uwezi/Eduino/README.md

# Eduino
Another ATmega32U4 breakout board
