uwezi/Eduino/documentation/20230210_eduino_pinout.pdf

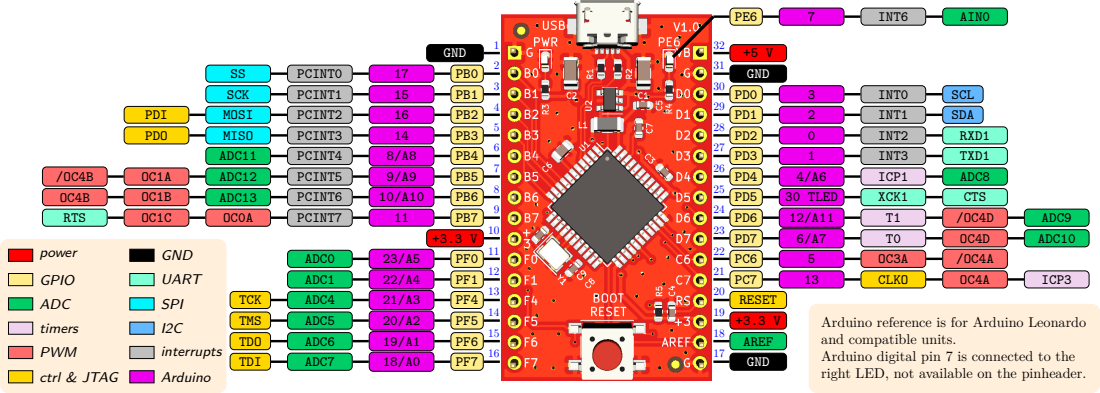
[picture p7: page 1]
32 GND; GND; AREF; RESET; PCINT0; SCK; PCINT1; PDI; MOSI; PCINT2; PDO; MISO; PCINT3; ADC11; PCINT4; ADC12; PCINT5; ADC13; PCINT6; RTS; PCINT7; ADC0; ADC1; TCK; ADC4; TMS; ADC5; TDO; ADC6; TDI; ADC7; CLKO; ICP3; INT0; SCL; INT1; SDA; INT2; RXD1; INT3; TXD1; ICP1; ADC8; 30 TLED; XCK1; CTS; ADC9; ADC10; INT6; AIN0; power; ctrl & JTAG; Arduino; GPIO; ADC; UART; SPI; timers; PWM; interrupts

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
