uwezi/Eduino/kicad/20210211_eduino.kicad_pcb

## KiCad design kicad/20210211_eduino.kicad_pcb (2021-02-11)

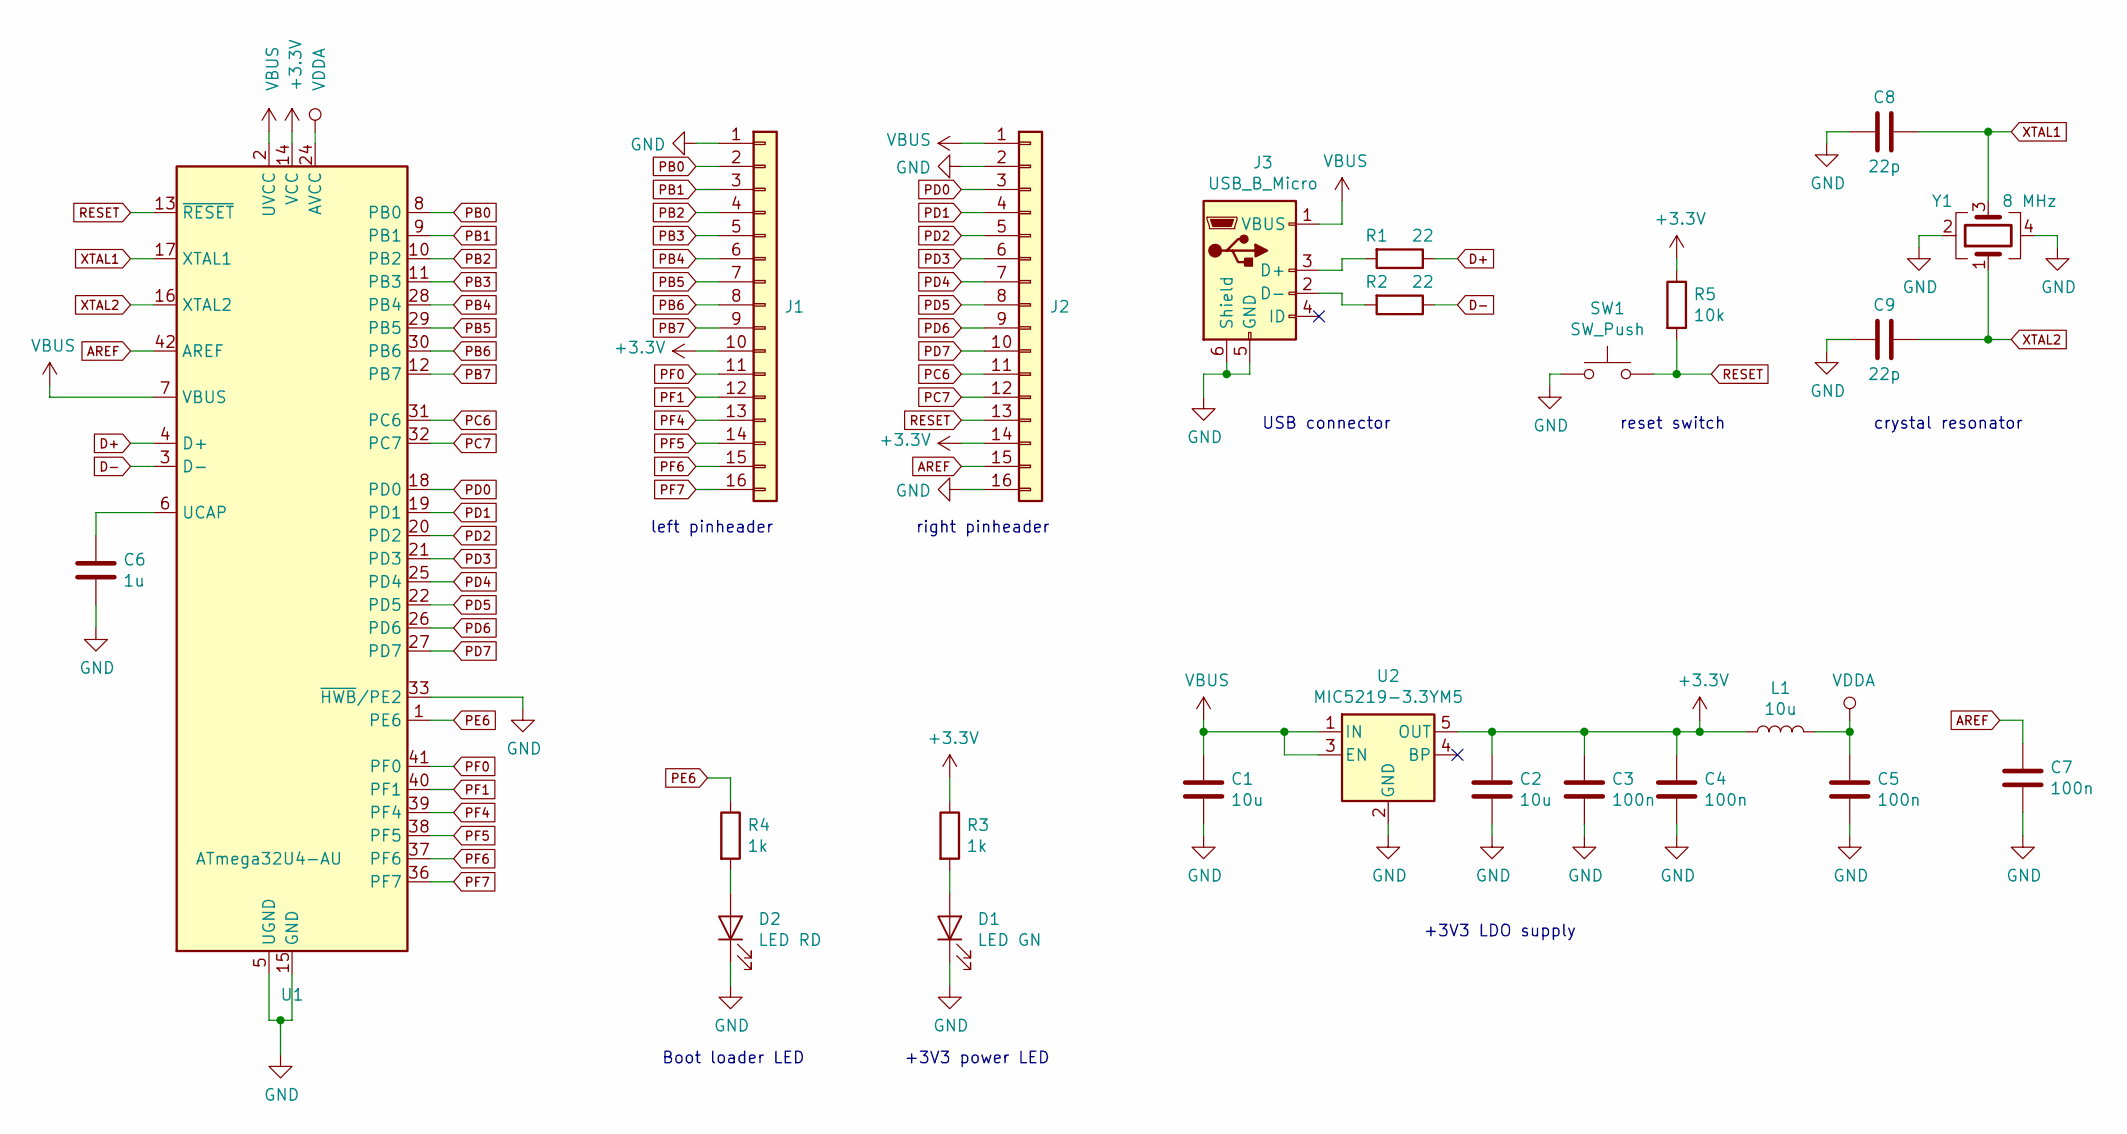
[picture p8: schematic 20210211_eduino.sch, ATmega32U4 Eduino]

Parts:
C1, C2: 10u; C_1206_3216Metric
C3, C4, C5, C7: 100n; C_0603_1608Metric
C6: 1u; C_0805_2012Metric
C8, C9: 22p; C_0603_1608Metric
D1: LED GN; LED_0603_1608Metric
D2: LED RD; LED_0603_1608Metric
J1, J2: Conn_01x16; PinHeader_1x16_P2.54mm_Vertical
J3: USB_B_Micro; micro-5P-Flat-welding-High-temperature_C40942
L1: 10u; L_1206_3216Metric
R1, R2: 22; R_0603_1608Metric
R3, R4: 1k; R_0603_1608Metric
R5: 10k; R_0603_1608Metric
SW1: SW_Push; SW_Push_1P1T_NO_6x6mm_H9.5mm
U1: ATmega32U4-AU; TQFP-44_10x10mm_P0.8mm
U2: MIC5219-3.3YM5; SOT-23-5
Y1: 8 MHz; Crystal_SMD_3225-4Pin_3.2x2.5mm

Connections:
+3V3: C2.1, C3.1, C4.1, J1.10, J2.14, L1.1, R3.1, R5.1, U1.14 (VCC), U1.34 (VCC), U2.5 (OUT)
AREF: C7.1, J2.15, U1.42 (AREF)
D+: R1.1, U1.4 (D+)
D-: R2.1, U1.3 (D-)
GND: C1.2, C2.2, C3.2, C4.2, C5.2, C6.2, C7.2, C8.1, C9.1, D1.1 (K), D2.1 (K), J1.1, J2.2, J2.16, J3.5 (GND), J3.6 (Shield), SW1.1, U1.5 (UGND), U1.15 (GND), U1.23 (GND), U1.33 (~HWB~/PE2), U1.35 (GND), U1.43 (GND), U2.2 (GND), Y1.2, Y1.4
unnamed: C6.1, U1.6 (UCAP)
unnamed: C8.2, U1.17 (XTAL1), Y1.3
unnamed: C9.2, U1.16 (XTAL2), Y1.1
unnamed: D1.2 (A), R3.2
unnamed: D2.2 (A), R4.2
unnamed: J3.2 (D-), R2.2
unnamed: J3.3 (D+), R1.2
PB0: J1.2, U1.8 (PB0)
PB1: J1.3, U1.9 (PB1)
PB2: J1.4, U1.10 (PB2)
PB3: J1.5, U1.11 (PB3)
PB4: J1.6, U1.28 (PB4)
PB5: J1.7, U1.29 (PB5)
PB6: J1.8, U1.30 (PB6)
PB7: J1.9, U1.12 (PB7)
PC6: J2.11, U1.31 (PC6)
PC7: J2.12, U1.32 (PC7)
PD0: J2.3, U1.18 (PD0)
PD1: J2.4, U1.19 (PD1)
PD2: J2.5, U1.20 (PD2)
PD3: J2.6, U1.21 (PD3)
PD4: J2.7, U1.25 (PD4)
PD5: J2.8, U1.22 (PD5)
PD6: J2.9, U1.26 (PD6)
PD7: J2.10, U1.27 (PD7)
PE6: R4.1, U1.1 (PE6)
PF0: J1.11, U1.41 (PF0)
PF1: J1.12, U1.40 (PF1)
PF4: J1.13, U1.39 (PF4)
PF5: J1.14, U1.38 (PF5)
PF6: J1.15, U1.37 (PF6)
PF7: J1.16, U1.36 (PF7)
RESET: J2.13, R5.2, SW1.2, U1.13 (~RESET)
VBUS: C1.1, J2.1, J3.1 (VBUS), U1.2 (UVCC), U1.7 (VBUS), U2.1 (IN), U2.3 (EN)
VDDA: C5.1, L1.2, U1.24 (AVCC), U1.44 (AVCC)

Notes on the sheet:
+3V3 power LED
Boot loader LED
left pinheader
right pinheader
+3V3 LDO supply
USB connector
reset switch
crystal resonator

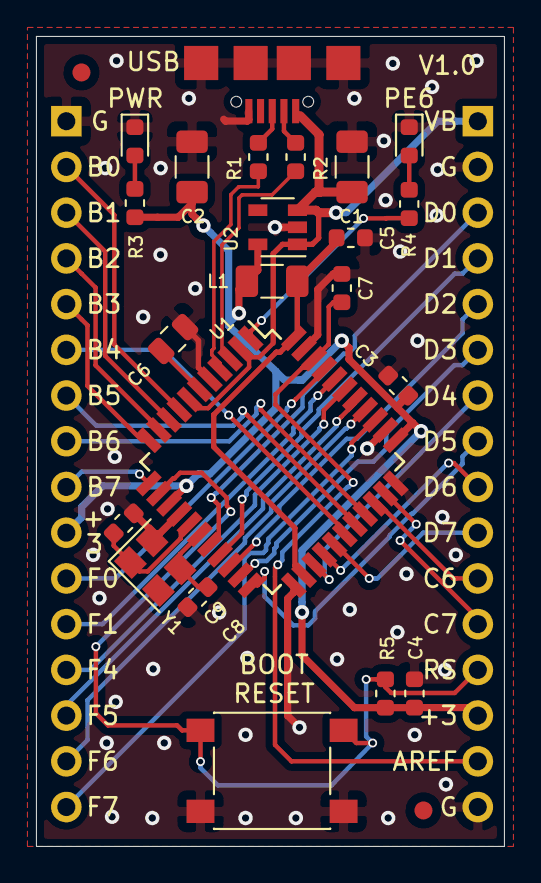
[picture p9: board 20210211_eduino.kicad_pcb from above]

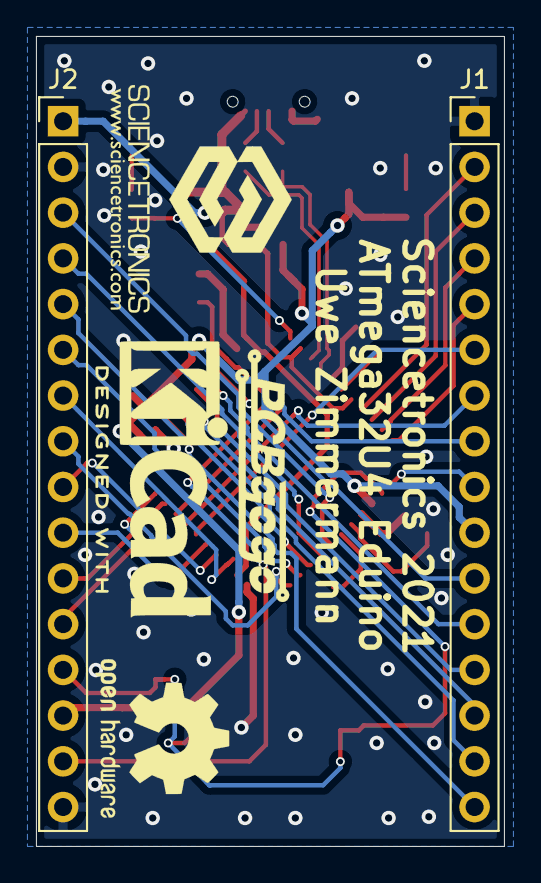
[picture p10: board 20210211_eduino.kicad_pcb from below]

Board: 4 copper layers, 26.0 x 45.0 mm, 24 parts (2 on the bottom side), 40 nets.
