uwezi/Eduino/(commit log)

2021-02-11 Create kicad_files
2021-09-05 Bootloader
    I added the untidy version of the modified bootloader. There are two .hex files for the ATmega32U4 - one for 8 MHz (recommended at 3.3 V) and one for 16 MHz (on your own risk at 3.3 V).
    Changes made:
    - only one LED in comparison to the original
    - LED is connected to PE6
    Things to do:
    - VID/PID are borrowed from the compatible Sparkfun Pro Micro
    - tidy upp
2023-02-10 Add files via upload
    added information about PD5 = TLED = Arduino pin #30
